FoxCutter/486Dev/README.md

# 486Dev
Repo for the 486 breadboard computer project
