FoxCutter/486Dev/Support Board/Support Board.kicad_pcb

## KiCad design Support Board/Support Board.kicad_pcb (2023-06-12)

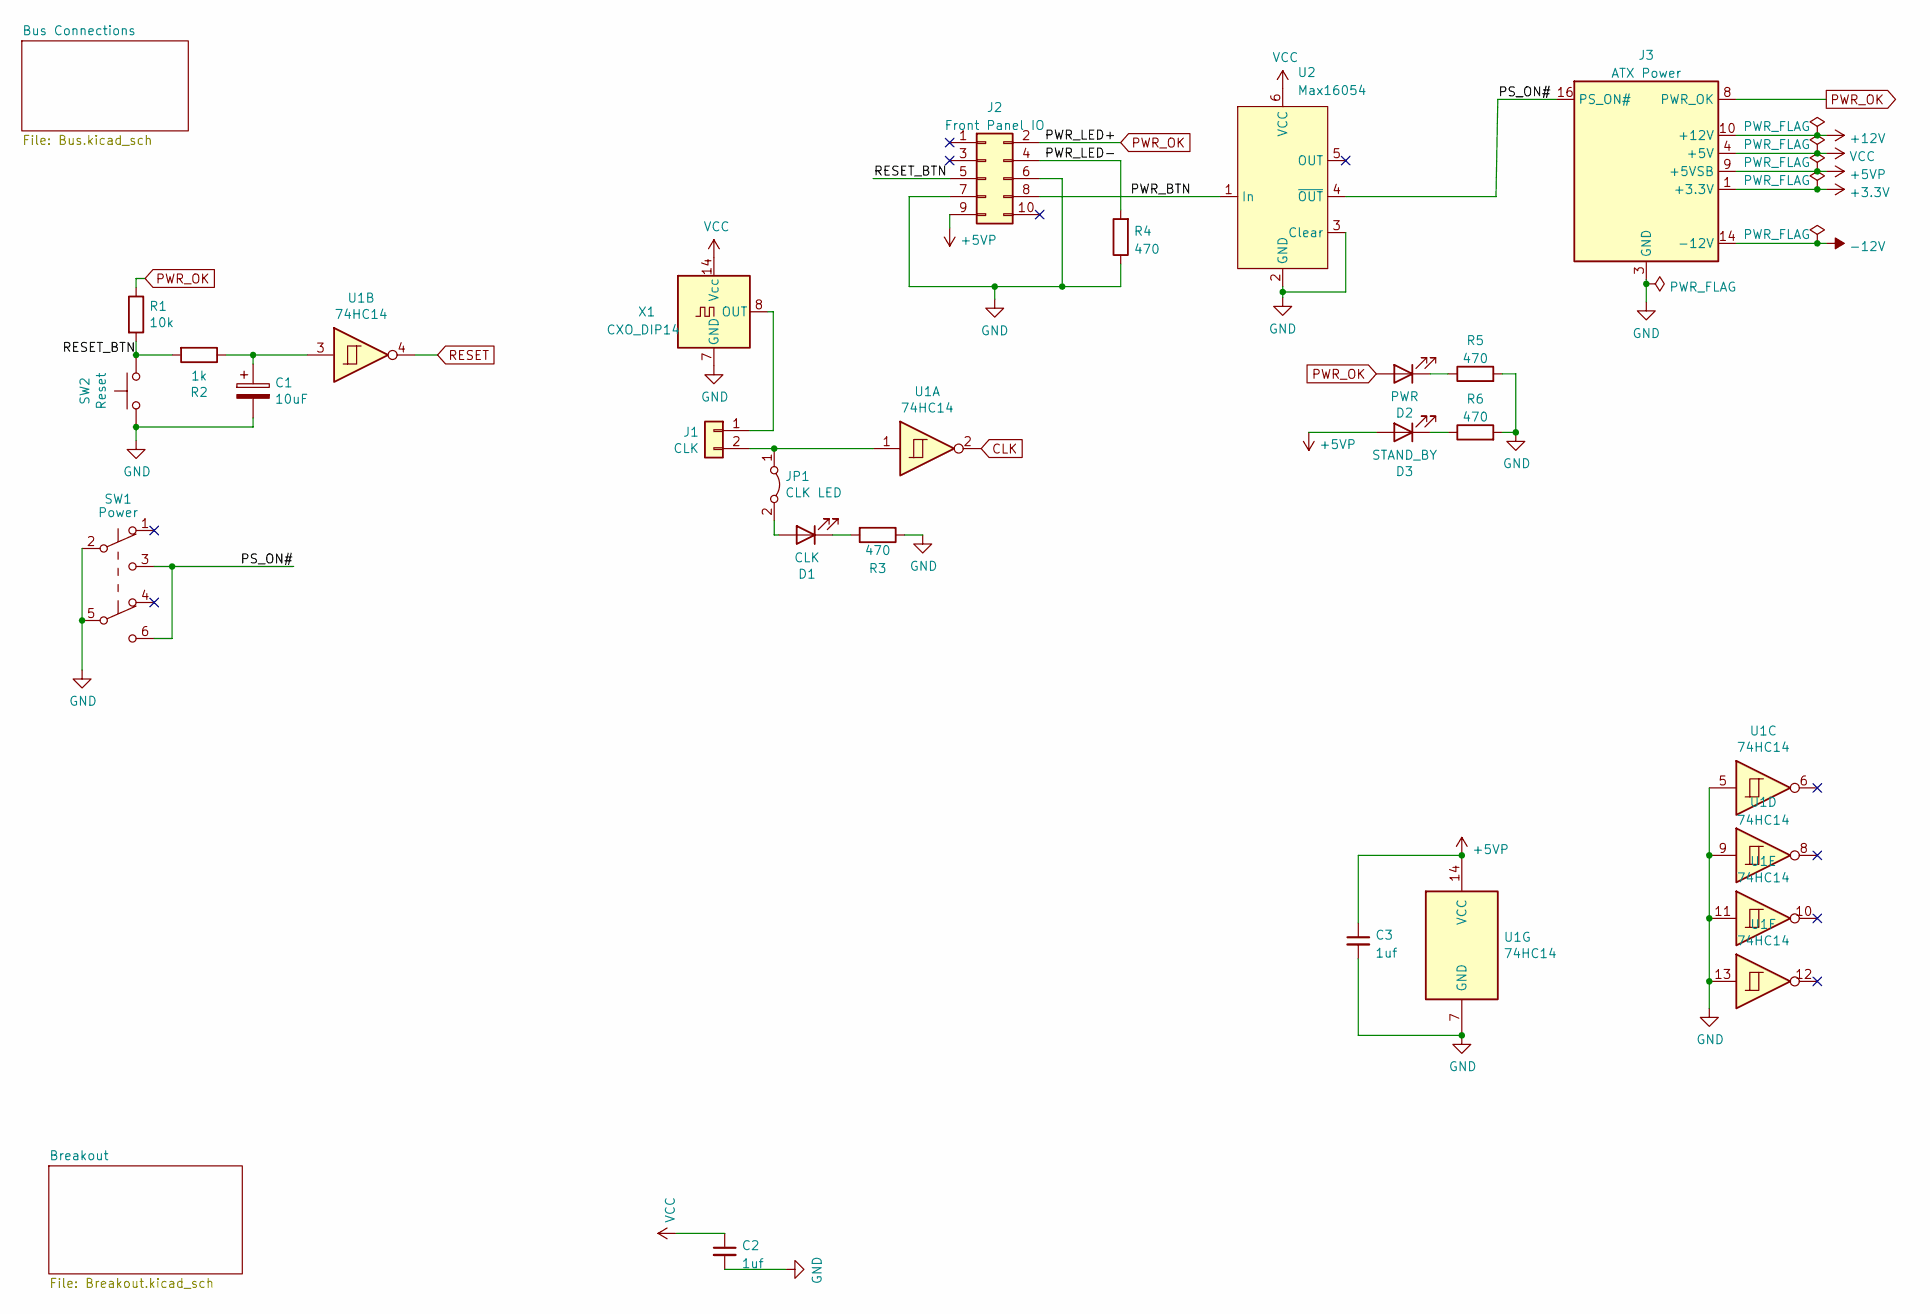
[picture p2: schematic Support Board.kicad_sch]

Parts:
C1: 10uF; CP_Radial_D5.0mm_P2.50mm
C2, C3: 1uf; C_0805_2012Metric_Pad1.18x1.45mm_HandSolder
D1: CLK; LED_0805_2012Metric_Pad1.15x1.40mm_HandSolder
D2: PWR; LED_0805_2012Metric_Pad1.15x1.40mm_HandSolder
D3: STAND_BY; LED_0805_2012Metric_Pad1.15x1.40mm_HandSolder
J1: CLK; PinHeader_1x02_P2.54mm_Vertical
J2: Front Panel IO; PinHeader_2x05_P2.54mm_Vertical
J3: ATX Power; Molex_Mini-Fit_Jr_5566-24A_2x12_P4.20mm_Vertical
JP1: CLK LED; PinHeader_1x02_P2.54mm_Vertical
R1: 10k; R_0805_2012Metric_Pad1.20x1.40mm_HandSolder
R2: 1k; R_0805_2012Metric_Pad1.20x1.40mm_HandSolder
R3, R4, R5, R6: 470; R_0805_2012Metric_Pad1.20x1.40mm_HandSolder
SW1: Power; 7mm x 7mm Tactile Switch
SW2: Reset; SW_PUSH_6mm
U1: 74HC14; SO-14_5.3x10.2mm_P1.27mm
U2: Max16054; TSOT-23-6
X1: CXO_DIP14; Oscillator_DIP-14

Connections:
+3.3V: J3.1 (+3.3V), J3.2 (+3.3V), J3.12 (+3.3V), J3.13 (+3.3V); also elsewhere on the board
+5VP: C3.1, D3.2 (A), J2.9, J3.9 (+5VSB), U1.14 (VCC); also elsewhere on the board
+12V: J3.10 (+12V), J3.11 (+12V); also elsewhere on the board
-12V: J3.14 (-12V); also elsewhere on the board
/PS_ON#: J3.16 (PS_ON#), SW1.3 (C), SW1.6 (C), U2.4 (~OUT)
/PWR_BTN: J2.8, U2.1 (In)
/PWR_LED-: J2.4, R4.2
/RESET_BTN: J2.5, R1.2, R2.2, SW2.2
CLK: U1.2; also elsewhere on the board
GND: C1.2, C2.2, C3.2, J2.6, J2.7, J3.3 (GND), J3.5 (GND), J3.7 (GND), J3.15 (GND), J3.17 (GND), J3.18 (GND), J3.19 (GND), J3.24 (GND), R3.1, R4.1, R5.2, R6.2, SW1.2 (B), SW1.5 (B), SW2.1, U1.5, U1.7 (GND), U1.9, U1.11, U1.13, U2.2 (GND), U2.3 (Clear), X1.7 (GND); also elsewhere on the board
unnamed: C1.1, R2.1, U1.3
unnamed: D1.1 (K), R3.2
unnamed: D1.2 (A), JP1.2 (B)
unnamed: D2.1 (K), R5.1
unnamed: D3.1 (K), R6.1
unnamed: J1.1, X1.8 (OUT)
unnamed: J1.2, JP1.1 (A), U1.1
PWR_OK: D2.2 (A), J2.2, J3.8 (PWR_OK), R1.1; also elsewhere on the board
RESET: U1.4; also elsewhere on the board
VCC: C2.1, J3.4 (+5V), J3.6 (+5V), J3.21 (+5V), J3.22 (+5V), J3.23 (+5V), U2.6 (VCC), X1.14 (Vcc); also elsewhere on the board

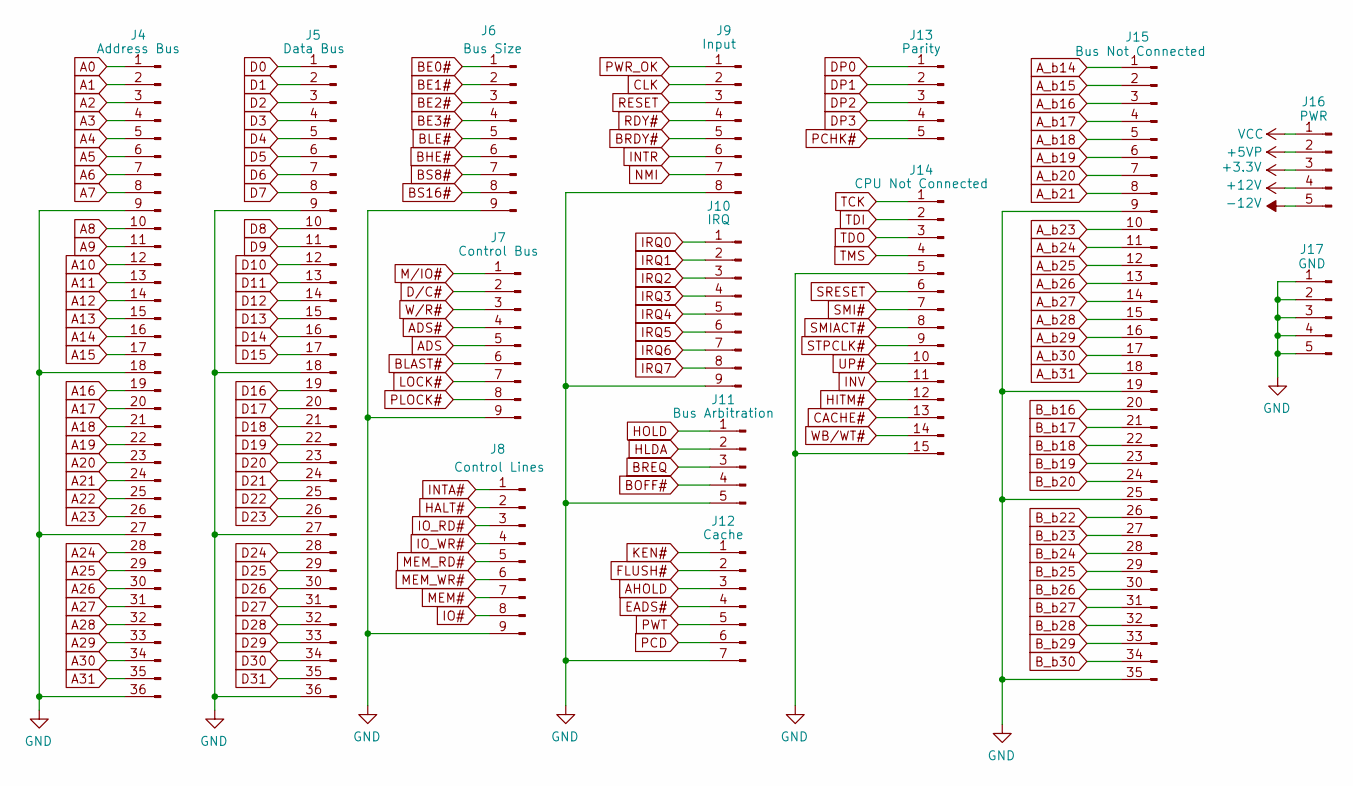
[picture p3: schematic Breakout.kicad_sch]

Parts:
J4: Address Bus; PinHeader_1x36_P2.54mm_Vertical
J5: Data Bus; PinHeader_1x36_P2.54mm_Vertical
J6: Bus Size; PinHeader_1x09_P2.54mm_Vertical
J7: Control Bus; PinHeader_1x09_P2.54mm_Vertical
J8: Control Lines; PinHeader_1x09_P2.54mm_Vertical
J9: Input; PinHeader_1x08_P2.54mm_Vertical
J10: IRQ; PinHeader_1x09_P2.54mm_Vertical
J11: Bus Arbitration; PinHeader_1x05_P2.54mm_Vertical
J12: Cache; PinHeader_1x07_P2.54mm_Vertical
J13: Parity; PinHeader_1x05_P2.54mm_Vertical
J14: CPU Not Connected; PinHeader_1x15_P2.54mm_Vertical
J15: Bus Not Connected; PinHeader_1x35_P2.54mm_Vertical
J16: PWR; PinHeader_1x05_P2.54mm_Vertical
J17: GND; PinHeader_1x05_P2.54mm_Vertical

Connections:
+3.3V: J16.3; also elsewhere on the board
+5VP: J16.2; also elsewhere on the board
+12V: J16.4; also elsewhere on the board
-12V: J16.5; also elsewhere on the board
A0: J4.1; also elsewhere on the board
A1: J4.2; also elsewhere on the board
A2: J4.3; also elsewhere on the board
A3: J4.4; also elsewhere on the board
A4: J4.5; also elsewhere on the board
A5: J4.6; also elsewhere on the board
A6: J4.7; also elsewhere on the board
A7: J4.8; also elsewhere on the board
A8: J4.10; also elsewhere on the board
A9: J4.11; also elsewhere on the board
A10: J4.12; also elsewhere on the board
A11: J4.13; also elsewhere on the board
A12: J4.14; also elsewhere on the board
A13: J4.15; also elsewhere on the board
A14: J4.16; also elsewhere on the board
A15: J4.17; also elsewhere on the board
A16: J4.19; also elsewhere on the board
A17: J4.20; also elsewhere on the board
A18: J4.21; also elsewhere on the board
A19: J4.22; also elsewhere on the board
A20: J4.23; also elsewhere on the board
A21: J4.24; also elsewhere on the board
A22: J4.25; also elsewhere on the board
A23: J4.26; also elsewhere on the board
A24: J4.28; also elsewhere on the board
A25: J4.29; also elsewhere on the board
A26: J4.30; also elsewhere on the board
A27: J4.31; also elsewhere on the board
A28: J4.32; also elsewhere on the board
A29: J4.33; also elsewhere on the board
A30: J4.34; also elsewhere on the board
A31: J4.35; also elsewhere on the board
ADS: J7.5; also elsewhere on the board
ADS#: J7.4; also elsewhere on the board
AHOLD: J12.3; also elsewhere on the board
A_b14: J15.1; also elsewhere on the board
A_b15: J15.2; also elsewhere on the board
A_b16: J15.3; also elsewhere on the board
A_b17: J15.4; also elsewhere on the board
A_b18: J15.5; also elsewhere on the board
A_b19: J15.6; also elsewhere on the board
A_b20: J15.7; also elsewhere on the board
A_b21: J15.8; also elsewhere on the board
A_b23: J15.10; also elsewhere on the board
A_b24: J15.11; also elsewhere on the board
A_b25: J15.12; also elsewhere on the board
A_b26: J15.13; also elsewhere on the board
A_b27: J15.14; also elsewhere on the board
A_b28: J15.15; also elsewhere on the board
A_b29: J15.16; also elsewhere on the board
A_b30: J15.17; also elsewhere on the board
A_b31: J15.18; also elsewhere on the board
BE0#: J6.1; also elsewhere on the board
BE1#: J6.2; also elsewhere on the board
BE2#: J6.3; also elsewhere on the board
BE3#: J6.4; also elsewhere on the board
BHE#: J6.6; also elsewhere on the board
BLAST#: J7.6; also elsewhere on the board
BLE#: J6.5; also elsewhere on the board
BOFF#: J11.4; also elsewhere on the board
BRDY#: J9.5; also elsewhere on the board
BREQ: J11.3; also elsewhere on the board
BS8#: J6.7; also elsewhere on the board
BS16#: J6.8; also elsewhere on the board
B_b16: J15.20; also elsewhere on the board
B_b17: J15.21; also elsewhere on the board
B_b18: J15.22; also elsewhere on the board
B_b19: J15.23; also elsewhere on the board
B_b20: J15.24; also elsewhere on the board
B_b22: J15.26; also elsewhere on the board
B_b23: J15.27; also elsewhere on the board
B_b24: J15.28; also elsewhere on the board
B_b25: J15.29; also elsewhere on the board
B_b26: J15.30; also elsewhere on the board
B_b27: J15.31; also elsewhere on the board
B_b28: J15.32; also elsewhere on the board
B_b29: J15.33; also elsewhere on the board
B_b30: J15.34; also elsewhere on the board
CACHE#: J14.13; also elsewhere on the board
CLK: J9.2; also elsewhere on the board
D0: J5.1; also elsewhere on the board
D1: J5.2; also elsewhere on the board
D2: J5.3; also elsewhere on the board
D3: J5.4; also elsewhere on the board
D4: J5.5; also elsewhere on the board
D5: J5.6; also elsewhere on the board
D6: J5.7; also elsewhere on the board
D7: J5.8; also elsewhere on the board
D8: J5.10; also elsewhere on the board
D9: J5.11; also elsewhere on the board
D10: J5.12; also elsewhere on the board
D11: J5.13; also elsewhere on the board
D12: J5.14; also elsewhere on the board
D13: J5.15; also elsewhere on the board
D14: J5.16; also elsewhere on the board
D15: J5.17; also elsewhere on the board
D16: J5.19; also elsewhere on the board
D17: J5.20; also elsewhere on the board
D18: J5.21; also elsewhere on the board
D19: J5.22; also elsewhere on the board
D20: J5.23; also elsewhere on the board
D21: J5.24; also elsewhere on the board
D22: J5.25; also elsewhere on the board
D23: J5.26; also elsewhere on the board
D24: J5.28; also elsewhere on the board
D25: J5.29; also elsewhere on the board
D26: J5.30; also elsewhere on the board
D27: J5.31; also elsewhere on the board
D28: J5.32; also elsewhere on the board
D29: J5.33; also elsewhere on the board
D30: J5.34; also elsewhere on the board
D31: J5.35; also elsewhere on the board
DP0: J13.1; also elsewhere on the board
DP1: J13.2; also elsewhere on the board
DP2: J13.3; also elsewhere on the board
DP3: J13.4; also elsewhere on the board
D/C#: J7.2; also elsewhere on the board
EADS#: J12.4; also elsewhere on the board
FLUSH#: J12.2; also elsewhere on the board
GND: J4.9, J4.18, J4.27, J4.36, J5.9, J5.18, J5.27, J5.36, J6.9, J7.9, J8.9, J9.8, J10.9, J11.5, J12.7, J14.5, J14.15, J15.9, J15.19, J15.25, J15.35, J17.1, J17.2, J17.3, J17.4, J17.5; also elsewhere on the board
HALT#: J8.2; also elsewhere on the board
HITM#: J14.12; also elsewhere on the board
HLDA: J11.2; also elsewhere on the board
HOLD: J11.1; also elsewhere on the board
INTA#: J8.1; also elsewhere on the board
INTR: J9.6; also elsewhere on the board
INV: J14.11; also elsewhere on the board
IO#: J8.8; also elsewhere on the board
IO_RD#: J8.3; also elsewhere on the board
IO_WR#: J8.4; also elsewhere on the board
IRQ0: J10.1; also elsewhere on the board
IRQ1: J10.2; also elsewhere on the board
IRQ2: J10.3; also elsewhere on the board
IRQ3: J10.4; also elsewhere on the board
IRQ4: J10.5; also elsewhere on the board
IRQ5: J10.6; also elsewhere on the board
IRQ6: J10.7; also elsewhere on the board
IRQ7: J10.8; also elsewhere on the board
KEN#: J12.1; also elsewhere on the board
LOCK#: J7.7; also elsewhere on the board
MEM#: J8.7; also elsewhere on the board
MEM_RD#: J8.5; also elsewhere on the board
MEM_WR#: J8.6; also elsewhere on the board
M/IO#: J7.1; also elsewhere on the board
NMI: J9.7; also elsewhere on the board
PCD: J12.6; also elsewhere on the board
PCHK#: J13.5; also elsewhere on the board
PLOCK#: J7.8; also elsewhere on the board
PWR_OK: J9.1; also elsewhere on the board
PWT: J12.5; also elsewhere on the board
RDY#: J9.4; also elsewhere on the board
RESET: J9.3; also elsewhere on the board
SMI#: J14.7; also elsewhere on the board
SMIACT#: J14.8; also elsewhere on the board
SRESET: J14.6; also elsewhere on the board
STPCLK#: J14.9; also elsewhere on the board
TCK: J14.1; also elsewhere on the board
TDI: J14.2; also elsewhere on the board
TDO: J14.3; also elsewhere on the board
TMS: J14.4; also elsewhere on the board
UP#: J14.10; also elsewhere on the board
VCC: J16.1; also elsewhere on the board
WB/WT#: J14.14; also elsewhere on the board
W/R#: J7.3; also elsewhere on the board

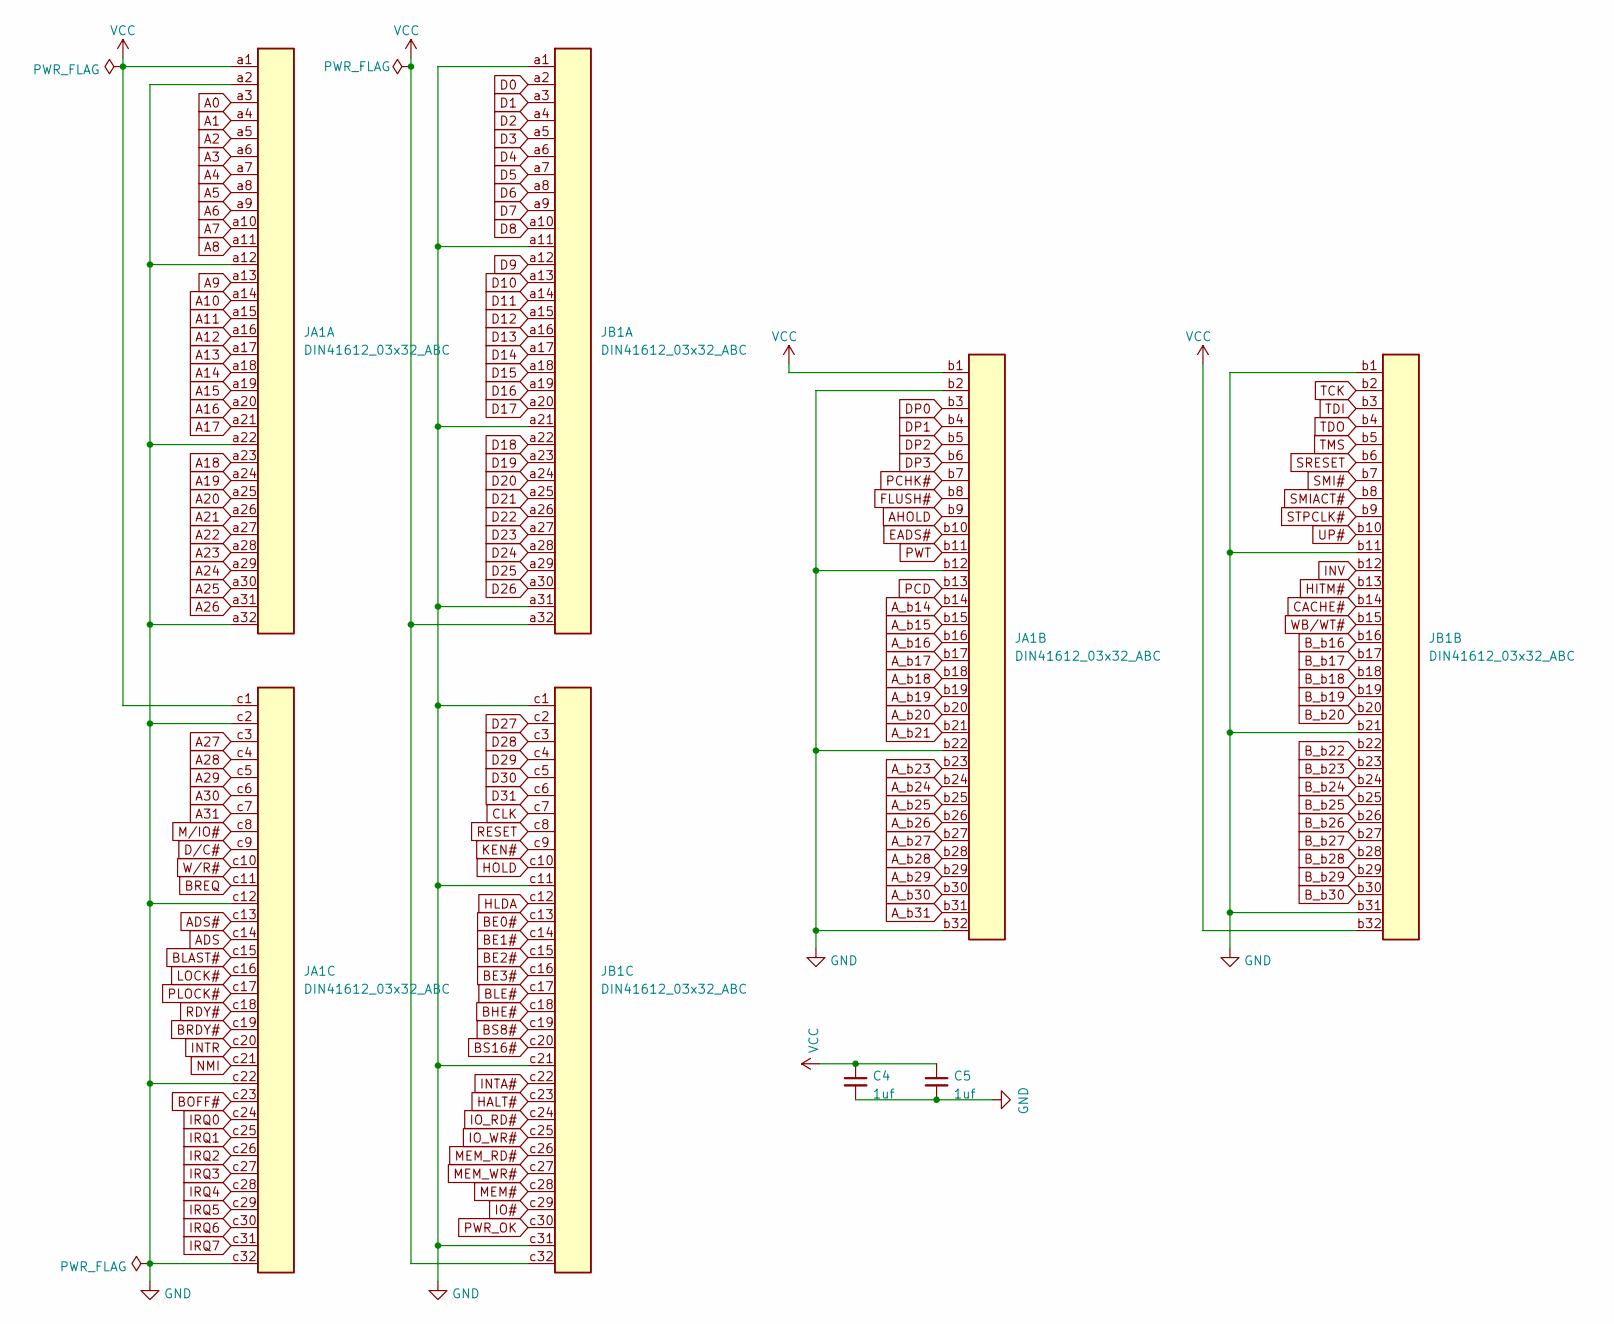
[picture p4: schematic Bus.kicad_sch]

Parts:
C4, C5: 1uf; C_0805_2012Metric_Pad1.18x1.45mm_HandSolder
JA1: DIN41612_03x32_ABC; DIN41612_R_3x32_Male_Horizontal_THT
JB1: DIN41612_03x32_ABC; DIN41612_R_3x32_Male_Horizontal_THT

Connections:
A0: JA1.a3; also elsewhere on the board
A1: JA1.a4; also elsewhere on the board
A2: JA1.a5; also elsewhere on the board
A3: JA1.a6; also elsewhere on the board
A4: JA1.a7; also elsewhere on the board
A5: JA1.a8; also elsewhere on the board
A6: JA1.a9; also elsewhere on the board
A7: JA1.a10; also elsewhere on the board
A8: JA1.a11; also elsewhere on the board
A9: JA1.a13; also elsewhere on the board
A10: JA1.a14; also elsewhere on the board
A11: JA1.a15; also elsewhere on the board
A12: JA1.a16; also elsewhere on the board
A13: JA1.a17; also elsewhere on the board
A14: JA1.a18; also elsewhere on the board
A15: JA1.a19; also elsewhere on the board
A16: JA1.a20; also elsewhere on the board
A17: JA1.a21; also elsewhere on the board
A18: JA1.a23; also elsewhere on the board
A19: JA1.a24; also elsewhere on the board
A20: JA1.a25; also elsewhere on the board
A21: JA1.a26; also elsewhere on the board
A22: JA1.a27; also elsewhere on the board
A23: JA1.a28; also elsewhere on the board
A24: JA1.a29; also elsewhere on the board
A25: JA1.a30; also elsewhere on the board
A26: JA1.a31; also elsewhere on the board
A27: JA1.c3; also elsewhere on the board
A28: JA1.c4; also elsewhere on the board
A29: JA1.c5; also elsewhere on the board
A30: JA1.c6; also elsewhere on the board
A31: JA1.c7; also elsewhere on the board
ADS: JA1.c14; also elsewhere on the board
ADS#: JA1.c13; also elsewhere on the board
AHOLD: JA1.b9; also elsewhere on the board
A_b14: JA1.b14; also elsewhere on the board
A_b15: JA1.b15; also elsewhere on the board
A_b16: JA1.b16; also elsewhere on the board
A_b17: JA1.b17; also elsewhere on the board
A_b18: JA1.b18; also elsewhere on the board
A_b19: JA1.b19; also elsewhere on the board
A_b20: JA1.b20; also elsewhere on the board
A_b21: JA1.b21; also elsewhere on the board
A_b23: JA1.b23; also elsewhere on the board
A_b24: JA1.b24; also elsewhere on the board
A_b25: JA1.b25; also elsewhere on the board
A_b26: JA1.b26; also elsewhere on the board
A_b27: JA1.b27; also elsewhere on the board
A_b28: JA1.b28; also elsewhere on the board
A_b29: JA1.b29; also elsewhere on the board
A_b30: JA1.b30; also elsewhere on the board
A_b31: JA1.b31; also elsewhere on the board
BE0#: JB1.c13; also elsewhere on the board
BE1#: JB1.c14; also elsewhere on the board
BE2#: JB1.c15; also elsewhere on the board
BE3#: JB1.c16; also elsewhere on the board
BHE#: JB1.c18; also elsewhere on the board
BLAST#: JA1.c15; also elsewhere on the board
BLE#: JB1.c17; also elsewhere on the board
BOFF#: JA1.c23; also elsewhere on the board
BRDY#: JA1.c19; also elsewhere on the board
BREQ: JA1.c11; also elsewhere on the board
BS8#: JB1.c19; also elsewhere on the board
BS16#: JB1.c20; also elsewhere on the board
B_b16: JB1.b16; also elsewhere on the board
B_b17: JB1.b17; also elsewhere on the board
B_b18: JB1.b18; also elsewhere on the board
B_b19: JB1.b19; also elsewhere on the board
B_b20: JB1.b20; also elsewhere on the board
B_b22: JB1.b22; also elsewhere on the board
B_b23: JB1.b23; also elsewhere on the board
B_b24: JB1.b24; also elsewhere on the board
B_b25: JB1.b25; also elsewhere on the board
B_b26: JB1.b26; also elsewhere on the board
B_b27: JB1.b27; also elsewhere on the board
B_b28: JB1.b28; also elsewhere on the board
B_b29: JB1.b29; also elsewhere on the board
B_b30: JB1.b30; also elsewhere on the board
CACHE#: JB1.b14; also elsewhere on the board
CLK: JB1.c7; also elsewhere on the board
D0: JB1.a2; also elsewhere on the board
D1: JB1.a3; also elsewhere on the board
D2: JB1.a4; also elsewhere on the board
D3: JB1.a5; also elsewhere on the board
D4: JB1.a6; also elsewhere on the board
D5: JB1.a7; also elsewhere on the board
D6: JB1.a8; also elsewhere on the board
D7: JB1.a9; also elsewhere on the board
D8: JB1.a10; also elsewhere on the board
D9: JB1.a12; also elsewhere on the board
D10: JB1.a13; also elsewhere on the board
D11: JB1.a14; also elsewhere on the board
D12: JB1.a15; also elsewhere on the board
D13: JB1.a16; also elsewhere on the board
D14: JB1.a17; also elsewhere on the board
D15: JB1.a18; also elsewhere on the board
D16: JB1.a19; also elsewhere on the board
D17: JB1.a20; also elsewhere on the board
D18: JB1.a22; also elsewhere on the board
D19: JB1.a23; also elsewhere on the board
D20: JB1.a24; also elsewhere on the board
D21: JB1.a25; also elsewhere on the board
D22: JB1.a26; also elsewhere on the board
D23: JB1.a27; also elsewhere on the board
D24: JB1.a28; also elsewhere on the board
D25: JB1.a29; also elsewhere on the board
D26: JB1.a30; also elsewhere on the board
D27: JB1.c2; also elsewhere on the board
D28: JB1.c3; also elsewhere on the board
D29: JB1.c4; also elsewhere on the board
D30: JB1.c5; also elsewhere on the board
D31: JB1.c6; also elsewhere on the board
DP0: JA1.b3; also elsewhere on the board
DP1: JA1.b4; also elsewhere on the board
DP2: JA1.b5; also elsewhere on the board
DP3: JA1.b6; also elsewhere on the board
D/C#: JA1.c9; also elsewhere on the board
EADS#: JA1.b10; also elsewhere on the board
FLUSH#: JA1.b8; also elsewhere on the board
GND: C4.2, C5.2, JA1.a2, JA1.a12, JA1.a22, JA1.a32, JA1.b2, JA1.b12, JA1.b22, JA1.b32, JA1.c2, JA1.c12, JA1.c22, JA1.c32, JB1.a1, JB1.a11, JB1.a21, JB1.a31, JB1.b1, JB1.b11, JB1.b21, JB1.b31, JB1.c1, JB1.c11, JB1.c21, JB1.c31; also elsewhere on the board
HALT#: JB1.c23; also elsewhere on the board
HITM#: JB1.b13; also elsewhere on the board
HLDA: JB1.c12; also elsewhere on the board
HOLD: JB1.c10; also elsewhere on the board
INTA#: JB1.c22; also elsewhere on the board
INTR: JA1.c20; also elsewhere on the board
INV: JB1.b12; also elsewhere on the board
IO#: JB1.c29; also elsewhere on the board
IO_RD#: JB1.c24; also elsewhere on the board
IO_WR#: JB1.c25; also elsewhere on the board
IRQ0: JA1.c24; also elsewhere on the board
IRQ1: JA1.c25; also elsewhere on the board
IRQ2: JA1.c26; also elsewhere on the board
IRQ3: JA1.c27; also elsewhere on the board
IRQ4: JA1.c28; also elsewhere on the board
IRQ5: JA1.c29; also elsewhere on the board
IRQ6: JA1.c30; also elsewhere on the board
IRQ7: JA1.c31; also elsewhere on the board
KEN#: JB1.c9; also elsewhere on the board
LOCK#: JA1.c16; also elsewhere on the board
MEM#: JB1.c28; also elsewhere on the board
MEM_RD#: JB1.c26; also elsewhere on the board
MEM_WR#: JB1.c27; also elsewhere on the board
M/IO#: JA1.c8; also elsewhere on the board
NMI: JA1.c21; also elsewhere on the board
PCD: JA1.b13; also elsewhere on the board
PCHK#: JA1.b7; also elsewhere on the board
PLOCK#: JA1.c17; also elsewhere on the board
PWR_OK: JB1.c30; also elsewhere on the board
PWT: JA1.b11; also elsewhere on the board
RDY#: JA1.c18; also elsewhere on the board
RESET: JB1.c8; also elsewhere on the board
SMI#: JB1.b7; also elsewhere on the board
SMIACT#: JB1.b8; also elsewhere on the board
SRESET: JB1.b6; also elsewhere on the board
STPCLK#: JB1.b9; also elsewhere on the board
TCK: JB1.b2; also elsewhere on the board
TDI: JB1.b3; also elsewhere on the board
TDO: JB1.b4; also elsewhere on the board
TMS: JB1.b5; also elsewhere on the board
UP#: JB1.b10; also elsewhere on the board
VCC: C4.1, C5.1, JA1.a1, JA1.b1, JA1.c1, JB1.a32, JB1.b32, JB1.c32; also elsewhere on the board
WB/WT#: JB1.b15; also elsewhere on the board
W/R#: JA1.c10; also elsewhere on the board

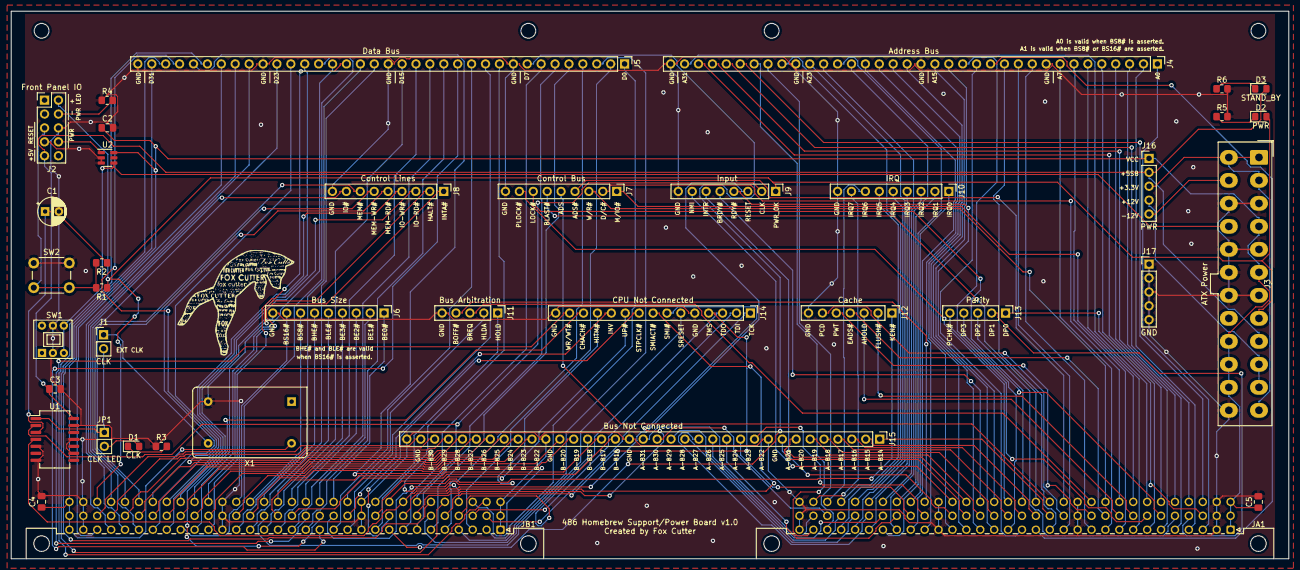
[picture p5: board Support Board.kicad_pcb from above]

Board: 2 copper layers, 233.3 x 100.0 mm, 43 parts (0 on the bottom side), 179 nets.

Other parts of the board:
REF1, REF2, REF3, REF4: MountingHole_2.7mm_M2.5_ISO7380
