FoxCutter/486Dev/Layout Template/Layout Template.kicad_pcb

## KiCad design Layout Template/Layout Template.kicad_pcb (2023-06-12)

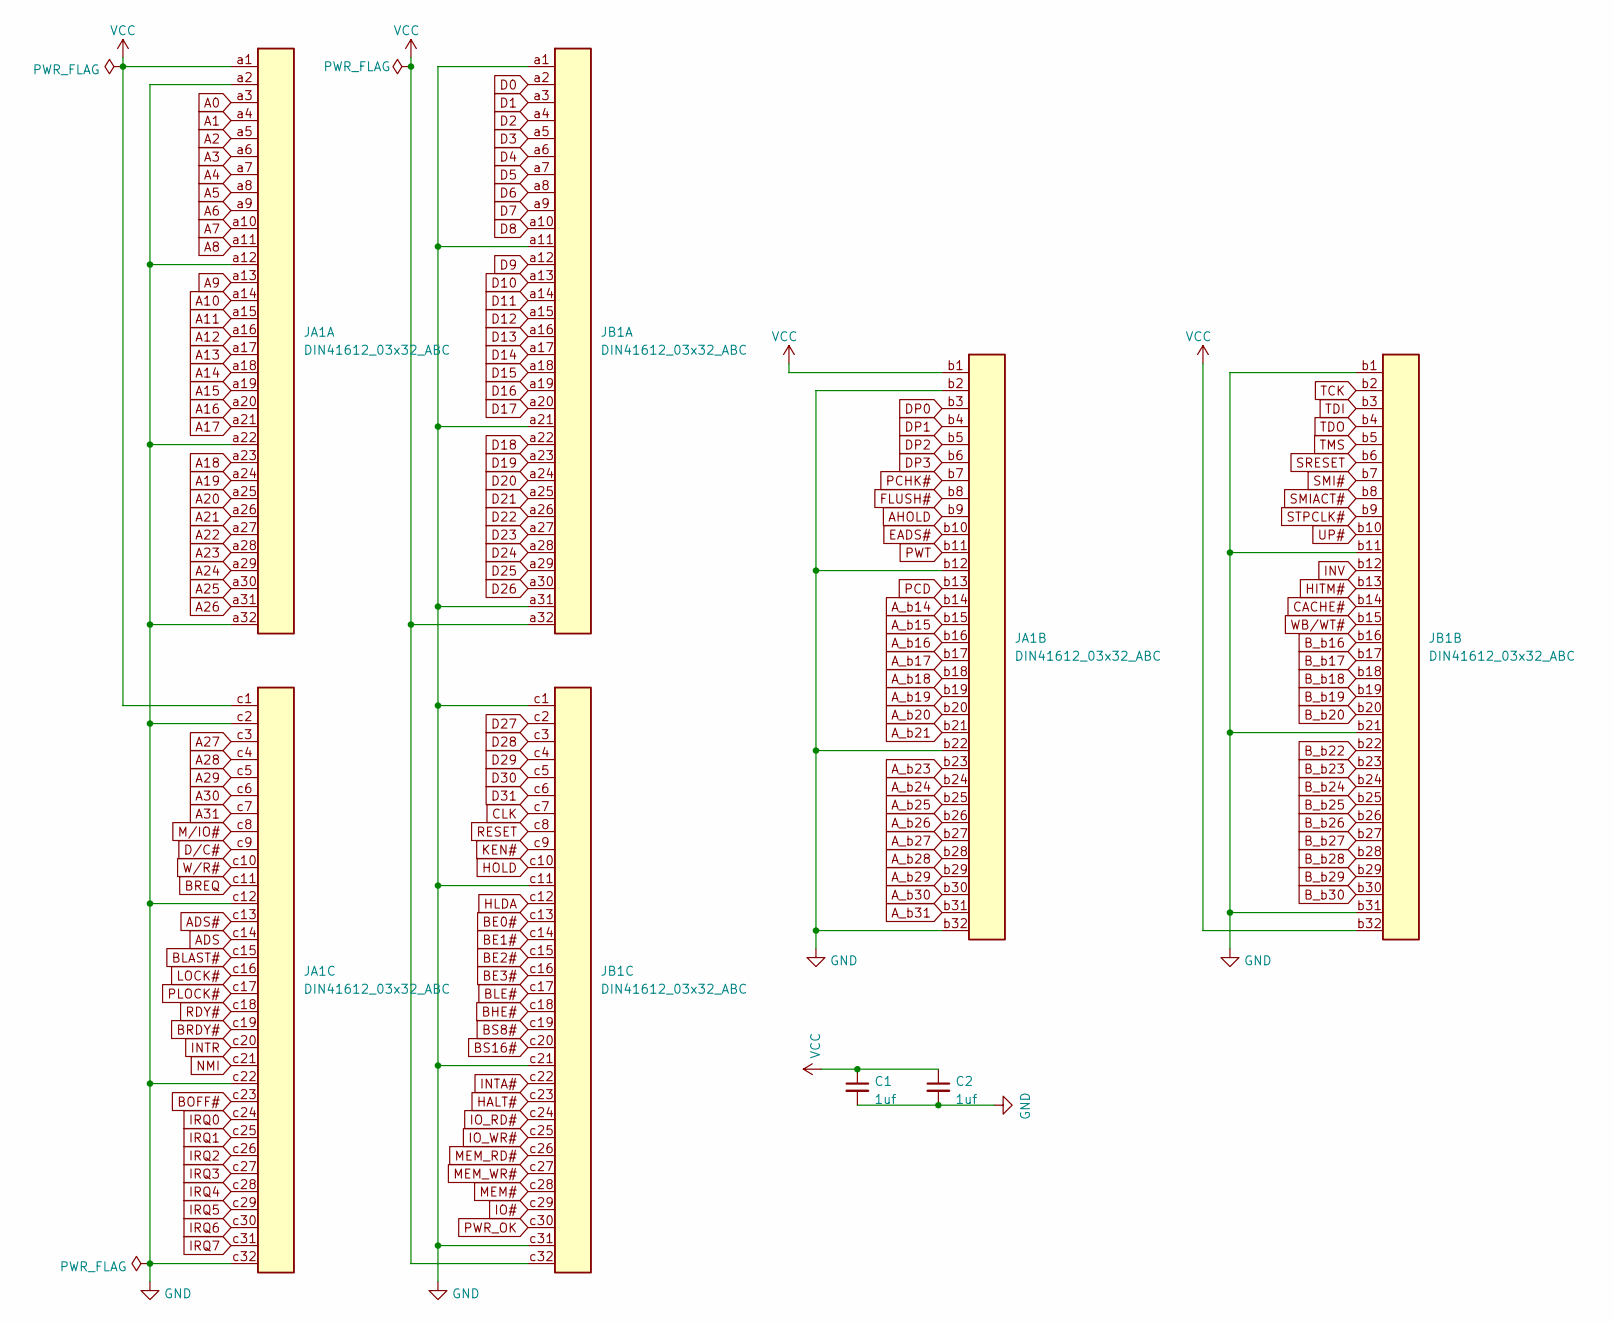
[picture p6: schematic Layout Template.kicad_sch]

Parts:
C1, C2: 1uf; C_Disc_D4.7mm_W2.5mm_P5.00mm
JA1: DIN41612_03x32_ABC; DIN41612_R_3x32_Male_Horizontal_THT
JB1: DIN41612_03x32_ABC; DIN41612_R_3x32_Male_Horizontal_THT

Connections:
A0: JA1.a3
A1: JA1.a4
A2: JA1.a5
A3: JA1.a6
A4: JA1.a7
A5: JA1.a8
A6: JA1.a9
A7: JA1.a10
A8: JA1.a11
A9: JA1.a13
A10: JA1.a14
A11: JA1.a15
A12: JA1.a16
A13: JA1.a17
A14: JA1.a18
A15: JA1.a19
A16: JA1.a20
A17: JA1.a21
A18: JA1.a23
A19: JA1.a24
A20: JA1.a25
A21: JA1.a26
A22: JA1.a27
A23: JA1.a28
A24: JA1.a29
A25: JA1.a30
A26: JA1.a31
A27: JA1.c3
A28: JA1.c4
A29: JA1.c5
A30: JA1.c6
A31: JA1.c7
ADS: JA1.c14
ADS#: JA1.c13
AHOLD: JA1.b9
A_b14: JA1.b14
A_b15: JA1.b15
A_b16: JA1.b16
A_b17: JA1.b17
A_b18: JA1.b18
A_b19: JA1.b19
A_b20: JA1.b20
A_b21: JA1.b21
A_b23: JA1.b23
A_b24: JA1.b24
A_b25: JA1.b25
A_b26: JA1.b26
A_b27: JA1.b27
A_b28: JA1.b28
A_b29: JA1.b29
A_b30: JA1.b30
A_b31: JA1.b31
BE0#: JB1.c13
BE1#: JB1.c14
BE2#: JB1.c15
BE3#: JB1.c16
BHE#: JB1.c18
BLAST#: JA1.c15
BLE#: JB1.c17
BOFF#: JA1.c23
BRDY#: JA1.c19
BREQ: JA1.c11
BS8#: JB1.c19
BS16#: JB1.c20
B_b16: JB1.b16
B_b17: JB1.b17
B_b18: JB1.b18
B_b19: JB1.b19
B_b20: JB1.b20
B_b22: JB1.b22
B_b23: JB1.b23
B_b24: JB1.b24
B_b25: JB1.b25
B_b26: JB1.b26
B_b27: JB1.b27
B_b28: JB1.b28
B_b29: JB1.b29
B_b30: JB1.b30
CACHE#: JB1.b14
CLK: JB1.c7
D0: JB1.a2
D1: JB1.a3
D2: JB1.a4
D3: JB1.a5
D4: JB1.a6
D5: JB1.a7
D6: JB1.a8
D7: JB1.a9
D8: JB1.a10
D9: JB1.a12
D10: JB1.a13
D11: JB1.a14
D12: JB1.a15
D13: JB1.a16
D14: JB1.a17
D15: JB1.a18
D16: JB1.a19
D17: JB1.a20
D18: JB1.a22
D19: JB1.a23
D20: JB1.a24
D21: JB1.a25
D22: JB1.a26
D23: JB1.a27
D24: JB1.a28
D25: JB1.a29
D26: JB1.a30
D27: JB1.c2
D28: JB1.c3
D29: JB1.c4
D30: JB1.c5
D31: JB1.c6
DP0: JA1.b3
DP1: JA1.b4
DP2: JA1.b5
DP3: JA1.b6
D/C#: JA1.c9
EADS#: JA1.b10
FLUSH#: JA1.b8
GND: C1.2, C2.2, JA1.a2, JA1.a12, JA1.a22, JA1.a32, JA1.b2, JA1.b12, JA1.b22, JA1.b32, JA1.c2, JA1.c12, JA1.c22, JA1.c32, JB1.a1, JB1.a11, JB1.a21, JB1.a31, JB1.b1, JB1.b11, JB1.b21, JB1.b31, JB1.c1, JB1.c11, JB1.c21, JB1.c31
HALT#: JB1.c23
HITM#: JB1.b13
HLDA: JB1.c12
HOLD: JB1.c10
INTA#: JB1.c22
INTR: JA1.c20
INV: JB1.b12
IO#: JB1.c29
IO_RD#: JB1.c24
IO_WR#: JB1.c25
IRQ0: JA1.c24
IRQ1: JA1.c25
IRQ2: JA1.c26
IRQ3: JA1.c27
IRQ4: JA1.c28
IRQ5: JA1.c29
IRQ6: JA1.c30
IRQ7: JA1.c31
KEN#: JB1.c9
LOCK#: JA1.c16
MEM#: JB1.c28
MEM_RD#: JB1.c26
MEM_WR#: JB1.c27
M/IO#: JA1.c8
NMI: JA1.c21
PCD: JA1.b13
PCHK#: JA1.b7
PLOCK#: JA1.c17
PWR_OK: JB1.c30
PWT: JA1.b11
RDY#: JA1.c18
RESET: JB1.c8
SMI#: JB1.b7
SMIACT#: JB1.b8
SRESET: JB1.b6
STPCLK#: JB1.b9
TCK: JB1.b2
TDI: JB1.b3
TDO: JB1.b4
TMS: JB1.b5
UP#: JB1.b10
VCC: C1.1, C2.1, JA1.a1, JA1.b1, JA1.c1, JB1.a32, JB1.b32, JB1.c32
WB/WT#: JB1.b15
W/R#: JA1.c10

Board: 2 copper layers, 8 parts (0 on the bottom side), 2 nets, no tracks yet.

Other parts of the board:
REF1, REF2, REF3, REF4: MountingHole_2.7mm_M2.5_ISO7380
