FoxCutter/486Dev/486 Breakout/486 Breakout.kicad_pcb

## KiCad design 486 Breakout/486 Breakout.kicad_pcb (2023-05-29)

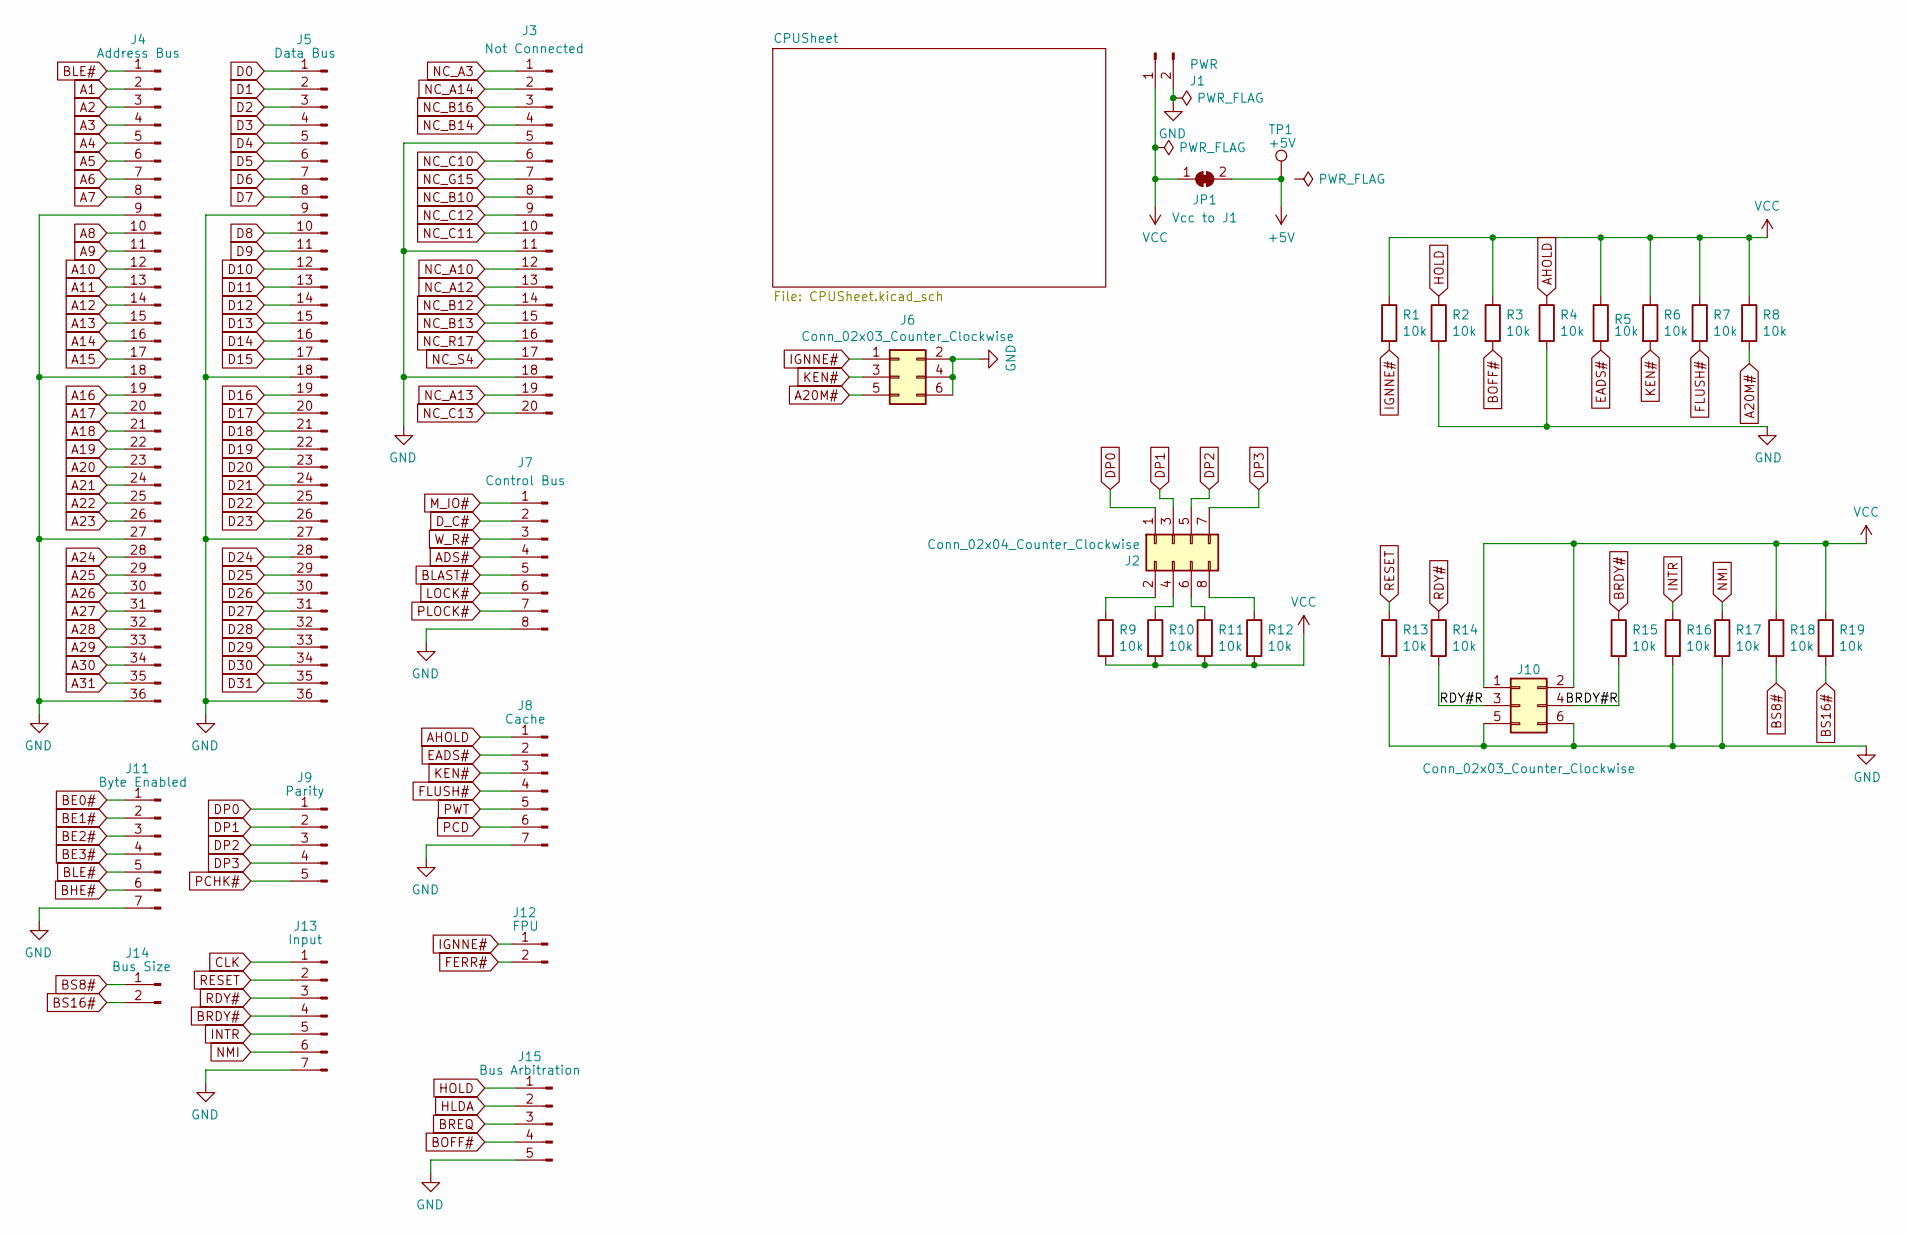
[picture p7: schematic 486 Breakout.kicad_sch]

Parts:
J1: PWR; PinHeader_1x02_P2.54mm_Vertical
J2: Conn_02x04_Counter_Clockwise; PinHeader_2x04_P2.54mm_Vertical
J3: Not Connected; PinHeader_1x20_P2.54mm_Vertical
J4: Address Bus; PinHeader_1x36_P2.54mm_Vertical
J5: Data Bus; PinHeader_1x36_P2.54mm_Vertical
J6, J10: Conn_02x03_Counter_Clockwise; PinHeader_2x03_P2.54mm_Vertical
J7: Control Bus; PinHeader_1x08_P2.54mm_Vertical
J8: Cache; PinHeader_1x07_P2.54mm_Vertical
J9: Parity; PinHeader_1x05_P2.54mm_Vertical
J11: Byte Enabled; PinHeader_1x07_P2.54mm_Vertical
J12: FPU; PinHeader_1x02_P2.54mm_Vertical
J13: Input; PinHeader_1x07_P2.54mm_Vertical
J14: Bus Size; PinHeader_1x02_P2.54mm_Vertical
J15: Bus Arbitration; PinHeader_1x05_P2.54mm_Vertical
JP1: Vcc to J1; SolderJumper-2_P1.3mm_Bridged_Pad1.0x1.5mm
R1, R2, R3, R4, R5, R6, R7, R8, R9, R10, R11, R12, R13, R14, R15, R16, R17, R18, R19: 10k; R_Axial_DIN0204_L3.6mm_D1.6mm_P7.62mm_Horizontal
TP1: +5V; TestPoint_Pad_2.0x2.0mm

Connections:
+5V: JP1.2 (B), TP1.1; also elsewhere on the board
/BRDY#R: J10.4, R15.2
/RDY#R: J10.3, R14.2
A1: J4.2; also elsewhere on the board
A2: J4.3; also elsewhere on the board
A3: J4.4; also elsewhere on the board
A4: J4.5; also elsewhere on the board
A5: J4.6; also elsewhere on the board
A6: J4.7; also elsewhere on the board
A7: J4.8; also elsewhere on the board
A8: J4.10; also elsewhere on the board
A9: J4.11; also elsewhere on the board
A10: J4.12; also elsewhere on the board
A11: J4.13; also elsewhere on the board
A12: J4.14; also elsewhere on the board
A13: J4.15; also elsewhere on the board
A14: J4.16; also elsewhere on the board
A15: J4.17; also elsewhere on the board
A16: J4.19; also elsewhere on the board
A17: J4.20; also elsewhere on the board
A18: J4.21; also elsewhere on the board
A19: J4.22; also elsewhere on the board
A20: J4.23; also elsewhere on the board
A20M#: J6.5, R8.2; also elsewhere on the board
A21: J4.24; also elsewhere on the board
A22: J4.25; also elsewhere on the board
A23: J4.26; also elsewhere on the board
A24: J4.28; also elsewhere on the board
A25: J4.29; also elsewhere on the board
A26: J4.30; also elsewhere on the board
A27: J4.31; also elsewhere on the board
A28: J4.32; also elsewhere on the board
A29: J4.33; also elsewhere on the board
A30: J4.34; also elsewhere on the board
A31: J4.35; also elsewhere on the board
ADS#: J7.4; also elsewhere on the board
AHOLD: J8.1, R4.1; also elsewhere on the board
BE0#: J11.1; also elsewhere on the board
BE1#: J11.2; also elsewhere on the board
BE2#: J11.3; also elsewhere on the board
BE3#: J11.4; also elsewhere on the board
BHE#: J11.6; also elsewhere on the board
BLAST#: J7.5; also elsewhere on the board
BLE#: J4.1, J11.5; also elsewhere on the board
BOFF#: J15.4, R3.2; also elsewhere on the board
BRDY#: J13.4, R15.1; also elsewhere on the board
BREQ: J15.3; also elsewhere on the board
BS8#: J14.1, R18.2; also elsewhere on the board
BS16#: J14.2, R19.2; also elsewhere on the board
CLK: J13.1; also elsewhere on the board
D0: J5.1; also elsewhere on the board
D1: J5.2; also elsewhere on the board
D2: J5.3; also elsewhere on the board
D3: J5.4; also elsewhere on the board
D4: J5.5; also elsewhere on the board
D5: J5.6; also elsewhere on the board
D6: J5.7; also elsewhere on the board
D7: J5.8; also elsewhere on the board
D8: J5.10; also elsewhere on the board
D9: J5.11; also elsewhere on the board
D10: J5.12; also elsewhere on the board
D11: J5.13; also elsewhere on the board
D12: J5.14; also elsewhere on the board
D13: J5.15; also elsewhere on the board
D14: J5.16; also elsewhere on the board
D15: J5.17; also elsewhere on the board
D16: J5.19; also elsewhere on the board
D17: J5.20; also elsewhere on the board
D18: J5.21; also elsewhere on the board
D19: J5.22; also elsewhere on the board
D20: J5.23; also elsewhere on the board
D21: J5.24; also elsewhere on the board
D22: J5.25; also elsewhere on the board
D23: J5.26; also elsewhere on the board
D24: J5.28; also elsewhere on the board
D25: J5.29; also elsewhere on the board
D26: J5.30; also elsewhere on the board
D27: J5.31; also elsewhere on the board
D28: J5.32; also elsewhere on the board
D29: J5.33; also elsewhere on the board
D30: J5.34; also elsewhere on the board
D31: J5.35; also elsewhere on the board
DP0: J2.1, J9.1; also elsewhere on the board
DP1: J2.3, J9.2; also elsewhere on the board
DP2: J2.5, J9.3; also elsewhere on the board
DP3: J2.7, J9.4; also elsewhere on the board
D_C#: J7.2; also elsewhere on the board
EADS#: J8.2, R5.2; also elsewhere on the board
FERR#: J12.2; also elsewhere on the board
FLUSH#: J8.4, R7.2; also elsewhere on the board
GND: J1.2, J3.5, J3.11, J3.18, J4.9, J4.18, J4.27, J4.36, J5.9, J5.18, J5.27, J5.36, J6.2, J6.4, J6.6, J7.8, J8.7, J10.5, J10.6, J11.7, J13.7, J15.5, R2.2, R4.2, R13.2, R16.2, R17.2; also elsewhere on the board
HLDA: J15.2; also elsewhere on the board
HOLD: J15.1, R2.1; also elsewhere on the board
IGNNE#: J6.1, J12.1, R1.2; also elsewhere on the board
INTR: J13.5, R16.1; also elsewhere on the board
KEN#: J6.3, J8.3, R6.2; also elsewhere on the board
LOCK#: J7.6; also elsewhere on the board
M_IO#: J7.1; also elsewhere on the board
NC_A3: J3.1; also elsewhere on the board
NC_A10: J3.12; also elsewhere on the board
NC_A12: J3.13; also elsewhere on the board
NC_A13: J3.19; also elsewhere on the board
NC_A14: J3.2; also elsewhere on the board
NC_B10: J3.8; also elsewhere on the board
NC_B12: J3.14; also elsewhere on the board
NC_B13: J3.15; also elsewhere on the board
NC_B14: J3.4; also elsewhere on the board
NC_B16: J3.3; also elsewhere on the board
NC_C10: J3.6; also elsewhere on the board
NC_C11: J3.10; also elsewhere on the board
NC_C12: J3.9; also elsewhere on the board
NC_C13: J3.20; also elsewhere on the board
NC_G15: J3.7; also elsewhere on the board
NC_R17: J3.16; also elsewhere on the board
NC_S4: J3.17; also elsewhere on the board
NMI: J13.6, R17.1; also elsewhere on the board
unnamed: J2.2, R9.1
unnamed: J2.4, R10.1
unnamed: J2.6, R11.1
unnamed: J2.8, R12.1
PCD: J8.6; also elsewhere on the board
PCHK#: J9.5; also elsewhere on the board
PLOCK#: J7.7; also elsewhere on the board
PWT: J8.5; also elsewhere on the board
RDY#: J13.3, R14.1; also elsewhere on the board
RESET: J13.2, R13.1; also elsewhere on the board
VCC: J1.1, J10.1, J10.2, JP1.1 (A), R1.1, R3.1, R5.1, R6.1, R7.1, R8.1, R9.2, R10.2, R11.2, R12.2, R18.1, R19.1; also elsewhere on the board
W_R#: J7.3; also elsewhere on the board

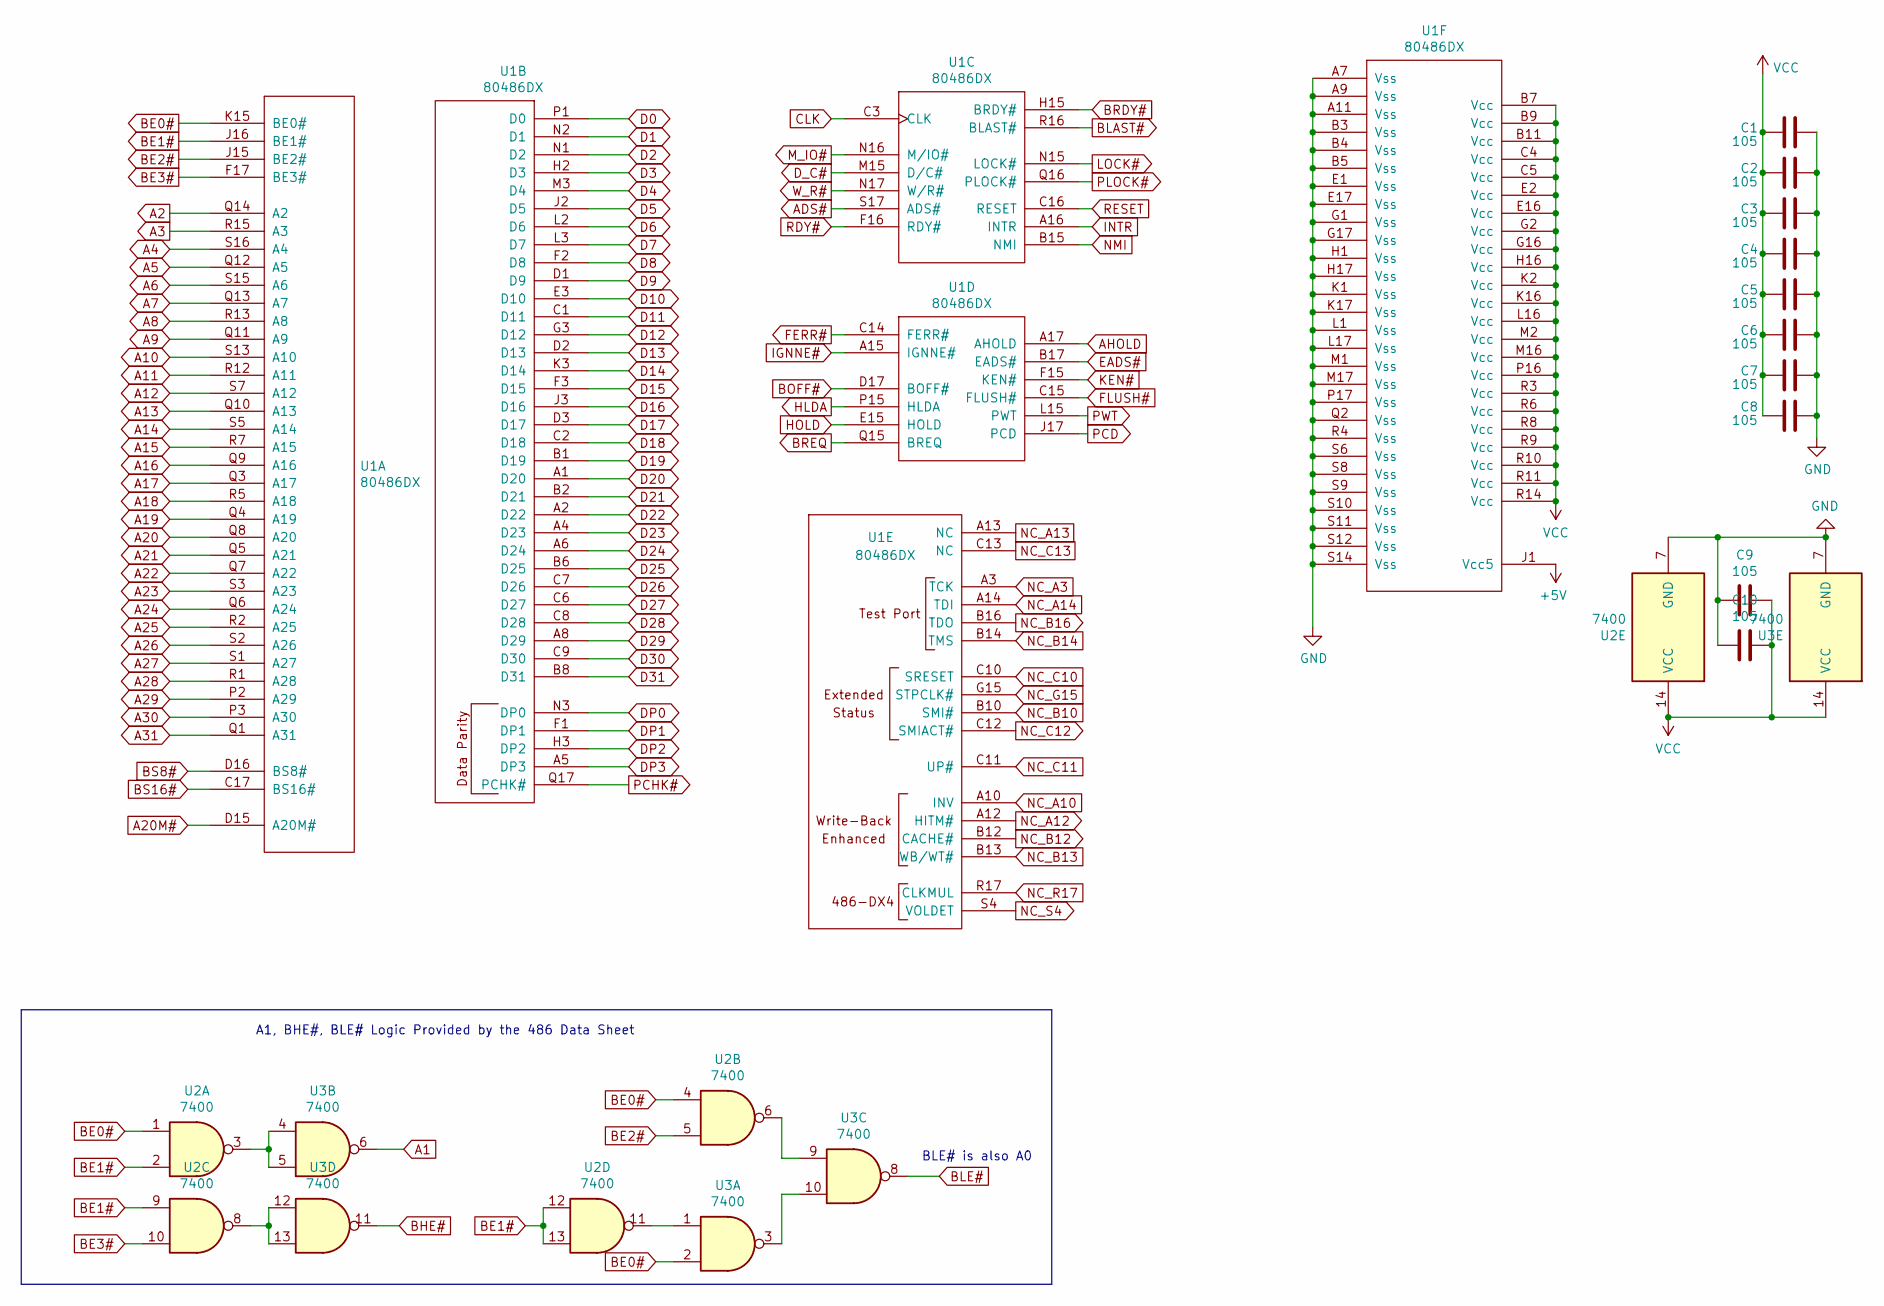
[picture p8: schematic CPUSheet.kicad_sch]

Parts:
C1, C2, C3, C4, C5, C6, C7, C8: 105; C_0805_2012Metric_Pad1.18x1.45mm_HandSolder
C9, C10: 105; C_Disc_D3.4mm_W2.1mm_P2.50mm
U1: 80486DX; PGA169
U2, U3: 7400; DIP-14_W7.62mm

Connections:
+5V: U1.J1 (Vcc5); also elsewhere on the board
A1: U3.6; also elsewhere on the board
A2: U1.Q14 (A2); also elsewhere on the board
A3: U1.R15 (A3); also elsewhere on the board
A4: U1.S16 (A4); also elsewhere on the board
A5: U1.Q12 (A5); also elsewhere on the board
A6: U1.S15 (A6); also elsewhere on the board
A7: U1.Q13 (A7); also elsewhere on the board
A8: U1.R13 (A8); also elsewhere on the board
A9: U1.Q11 (A9); also elsewhere on the board
A10: U1.S13 (A10); also elsewhere on the board
A11: U1.R12 (A11); also elsewhere on the board
A12: U1.S7 (A12); also elsewhere on the board
A13: U1.Q10 (A13); also elsewhere on the board
A14: U1.S5 (A14); also elsewhere on the board
A15: U1.R7 (A15); also elsewhere on the board
A16: U1.Q9 (A16); also elsewhere on the board
A17: U1.Q3 (A17); also elsewhere on the board
A18: U1.R5 (A18); also elsewhere on the board
A19: U1.Q4 (A19); also elsewhere on the board
A20: U1.Q8 (A20); also elsewhere on the board
A20M#: U1.D15 (A20M#); also elsewhere on the board
A21: U1.Q5 (A21); also elsewhere on the board
A22: U1.Q7 (A22); also elsewhere on the board
A23: U1.S3 (A23); also elsewhere on the board
A24: U1.Q6 (A24); also elsewhere on the board
A25: U1.R2 (A25); also elsewhere on the board
A26: U1.S2 (A26); also elsewhere on the board
A27: U1.S1 (A27); also elsewhere on the board
A28: U1.R1 (A28); also elsewhere on the board
A29: U1.P2 (A29); also elsewhere on the board
A30: U1.P3 (A30); also elsewhere on the board
A31: U1.Q1 (A31); also elsewhere on the board
ADS#: U1.S17 (ADS#); also elsewhere on the board
AHOLD: U1.A17 (AHOLD); also elsewhere on the board
BE0#: U1.K15 (BE0#), U2.1, U2.4, U3.2; also elsewhere on the board
BE1#: U1.J16 (BE1#), U2.2, U2.9, U2.12, U2.13; also elsewhere on the board
BE2#: U1.J15 (BE2#), U2.5; also elsewhere on the board
BE3#: U1.F17 (BE3#), U2.10; also elsewhere on the board
BHE#: U3.11; also elsewhere on the board
BLAST#: U1.R16 (BLAST#); also elsewhere on the board
BLE#: U3.8; also elsewhere on the board
BOFF#: U1.D17 (BOFF#); also elsewhere on the board
BRDY#: U1.H15 (BRDY#); also elsewhere on the board
BREQ: U1.Q15 (BREQ); also elsewhere on the board
BS8#: U1.D16 (BS8#); also elsewhere on the board
BS16#: U1.C17 (BS16#); also elsewhere on the board
CLK: U1.C3 (CLK); also elsewhere on the board
D0: U1.P1 (D0); also elsewhere on the board
D1: U1.N2 (D1); also elsewhere on the board
D2: U1.N1 (D2); also elsewhere on the board
D3: U1.H2 (D3); also elsewhere on the board
D4: U1.M3 (D4); also elsewhere on the board
D5: U1.J2 (D5); also elsewhere on the board
D6: U1.L2 (D6); also elsewhere on the board
D7: U1.L3 (D7); also elsewhere on the board
D8: U1.F2 (D8); also elsewhere on the board
D9: U1.D1 (D9); also elsewhere on the board
D10: U1.E3 (D10); also elsewhere on the board
D11: U1.C1 (D11); also elsewhere on the board
D12: U1.G3 (D12); also elsewhere on the board
D13: U1.D2 (D13); also elsewhere on the board
D14: U1.K3 (D14); also elsewhere on the board
D15: U1.F3 (D15); also elsewhere on the board
D16: U1.J3 (D16); also elsewhere on the board
D17: U1.D3 (D17); also elsewhere on the board
D18: U1.C2 (D18); also elsewhere on the board
D19: U1.B1 (D19); also elsewhere on the board
D20: U1.A1 (D20); also elsewhere on the board
D21: U1.B2 (D21); also elsewhere on the board
D22: U1.A2 (D22); also elsewhere on the board
D23: U1.A4 (D23); also elsewhere on the board
D24: U1.A6 (D24); also elsewhere on the board
D25: U1.B6 (D25); also elsewhere on the board
D26: U1.C7 (D26); also elsewhere on the board
D27: U1.C6 (D27); also elsewhere on the board
D28: U1.C8 (D28); also elsewhere on the board
D29: U1.A8 (D29); also elsewhere on the board
D30: U1.C9 (D30); also elsewhere on the board
D31: U1.B8 (D31); also elsewhere on the board
DP0: U1.N3 (DP0); also elsewhere on the board
DP1: U1.F1 (DP1); also elsewhere on the board
DP2: U1.H3 (DP2); also elsewhere on the board
DP3: U1.A5 (DP3); also elsewhere on the board
D_C#: U1.M15 (D/C#); also elsewhere on the board
EADS#: U1.B17 (EADS#); also elsewhere on the board
FERR#: U1.C14 (FERR#); also elsewhere on the board
FLUSH#: U1.C15 (FLUSH#); also elsewhere on the board
GND: C1.1, C2.1, C3.1, C4.1, C5.1, C6.1, C7.1, C8.1, C9.2, C10.2, U1.A7 (Vss), U1.A9 (Vss), U1.A11 (Vss), U1.B3 (Vss), U1.B4 (Vss), U1.B5 (Vss), U1.E1 (Vss), U1.E17 (Vss), U1.G1 (Vss), U1.G17 (Vss), U1.H1 (Vss), U1.H17 (Vss), U1.K1 (Vss), U1.K17 (Vss), U1.L1 (Vss), U1.L17 (Vss), U1.M1 (Vss), U1.M17 (Vss), U1.P17 (Vss), U1.Q2 (Vss), U1.R4 (Vss), U1.S6 (Vss), U1.S8 (Vss), U1.S9 (Vss), U1.S10 (Vss), U1.S11 (Vss), U1.S12 (Vss), U1.S14 (Vss), U2.7 (GND), U3.7 (GND); also elsewhere on the board
HLDA: U1.P15 (HLDA); also elsewhere on the board
HOLD: U1.E15 (HOLD); also elsewhere on the board
IGNNE#: U1.A15 (IGNNE#); also elsewhere on the board
INTR: U1.A16 (INTR); also elsewhere on the board
KEN#: U1.F15 (KEN#); also elsewhere on the board
LOCK#: U1.N15 (LOCK#); also elsewhere on the board
M_IO#: U1.N16 (M/IO#); also elsewhere on the board
NC_A3: U1.A3 (TCK); also elsewhere on the board
NC_A10: U1.A10 (INV); also elsewhere on the board
NC_A12: U1.A12 (HITM#); also elsewhere on the board
NC_A13: U1.A13 (NC); also elsewhere on the board
NC_A14: U1.A14 (TDI); also elsewhere on the board
NC_B10: U1.B10 (SMI#); also elsewhere on the board
NC_B12: U1.B12 (CACHE#); also elsewhere on the board
NC_B13: U1.B13 (WB/WT#); also elsewhere on the board
NC_B14: U1.B14 (TMS); also elsewhere on the board
NC_B16: U1.B16 (TDO); also elsewhere on the board
NC_C10: U1.C10 (SRESET); also elsewhere on the board
NC_C11: U1.C11 (UP#); also elsewhere on the board
NC_C12: U1.C12 (SMIACT#); also elsewhere on the board
NC_C13: U1.C13 (NC); also elsewhere on the board
NC_G15: U1.G15 (STPCLK#); also elsewhere on the board
NC_R17: U1.R17 (CLKMUL); also elsewhere on the board
NC_S4: U1.S4 (VOLDET); also elsewhere on the board
NMI: U1.B15 (NMI); also elsewhere on the board
unnamed: U2.3, U3.4, U3.5
unnamed: U2.6, U3.9
unnamed: U2.8, U3.12, U3.13
unnamed: U2.11, U3.1
unnamed: U3.3, U3.10
PCD: U1.J17 (PCD); also elsewhere on the board
PCHK#: U1.Q17 (PCHK#); also elsewhere on the board
PLOCK#: U1.Q16 (PLOCK#); also elsewhere on the board
PWT: U1.L15 (PWT); also elsewhere on the board
RDY#: U1.F16 (RDY#); also elsewhere on the board
RESET: U1.C16 (RESET); also elsewhere on the board
VCC: C1.2, C2.2, C3.2, C4.2, C5.2, C6.2, C7.2, C8.2, C9.1, C10.1, U1.B7 (Vcc), U1.B9 (Vcc), U1.B11 (Vcc), U1.C4 (Vcc), U1.C5 (Vcc), U1.E2 (Vcc), U1.E16 (Vcc), U1.G2 (Vcc), U1.G16 (Vcc), U1.H16 (Vcc), U1.K2 (Vcc), U1.K16 (Vcc), U1.L16 (Vcc), U1.M2 (Vcc), U1.M16 (Vcc), U1.P16 (Vcc), U1.R3 (Vcc), U1.R6 (Vcc), U1.R8 (Vcc), U1.R9 (Vcc), U1.R10 (Vcc), U1.R11 (Vcc), U1.R14 (Vcc), U2.14 (VCC), U3.14 (VCC); also elsewhere on the board
W_R#: U1.N17 (W/R#); also elsewhere on the board

Notes on the sheet:
A1, BHE#, BLE# Logic Provided by the 486 Data Sheet
BLE# is also A0

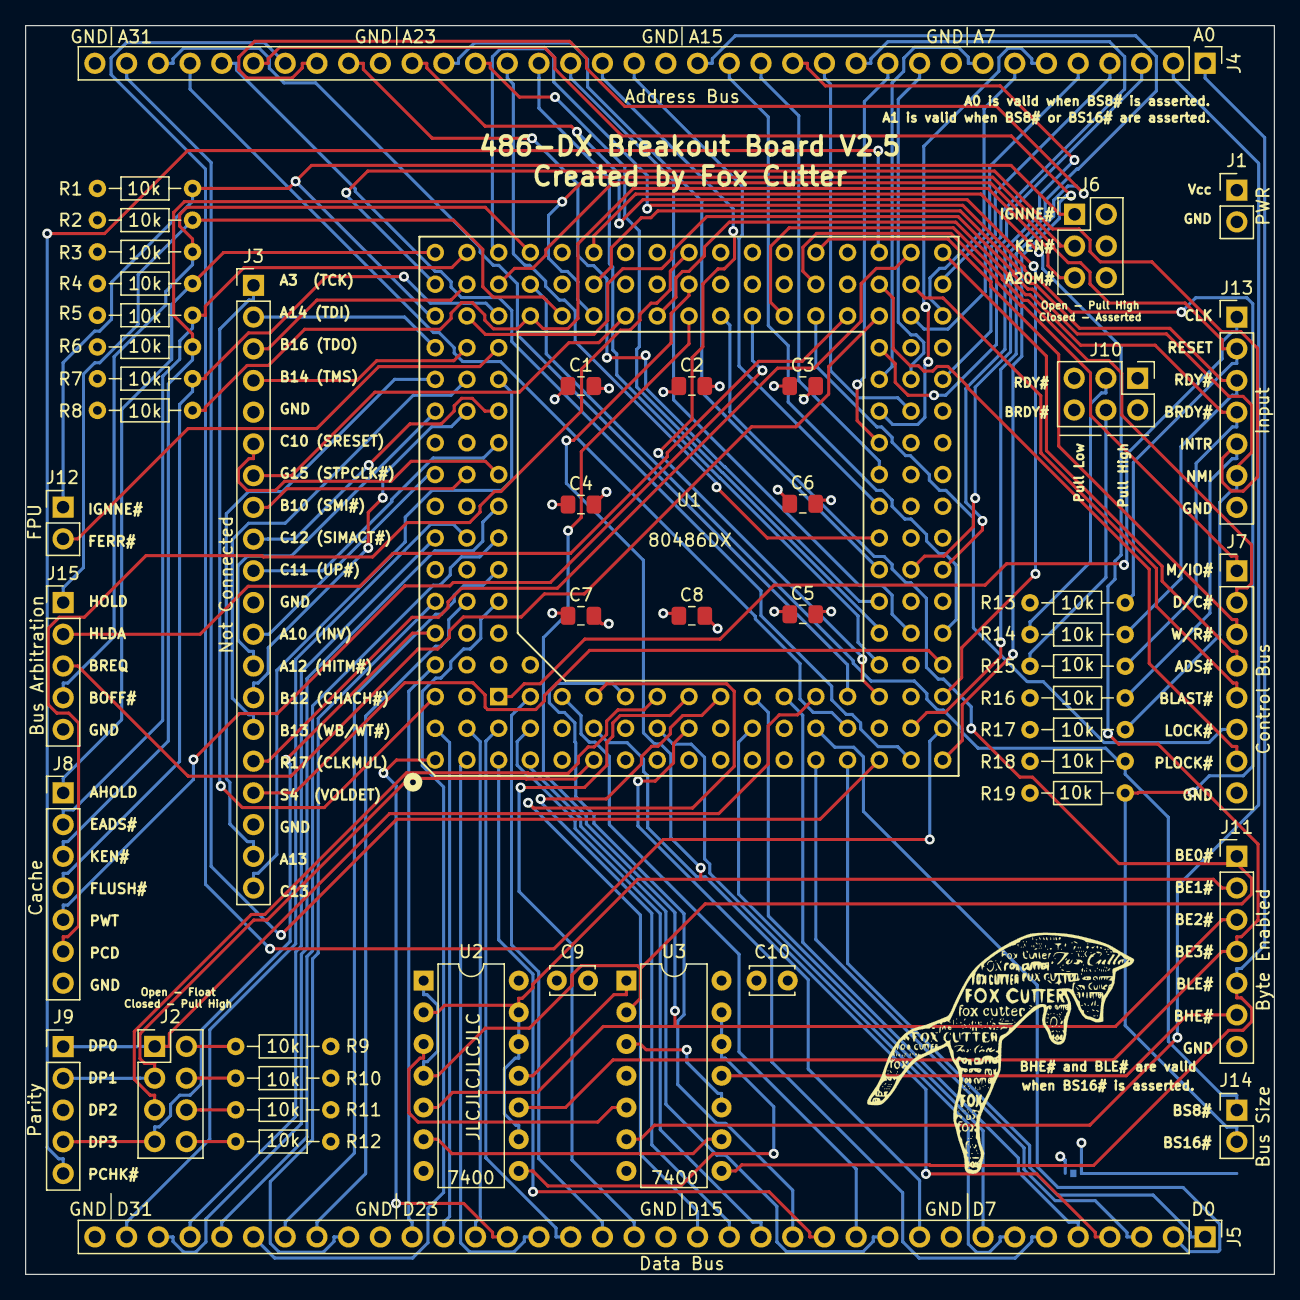
[picture p9: board 486 Breakout.kicad_pcb from above]

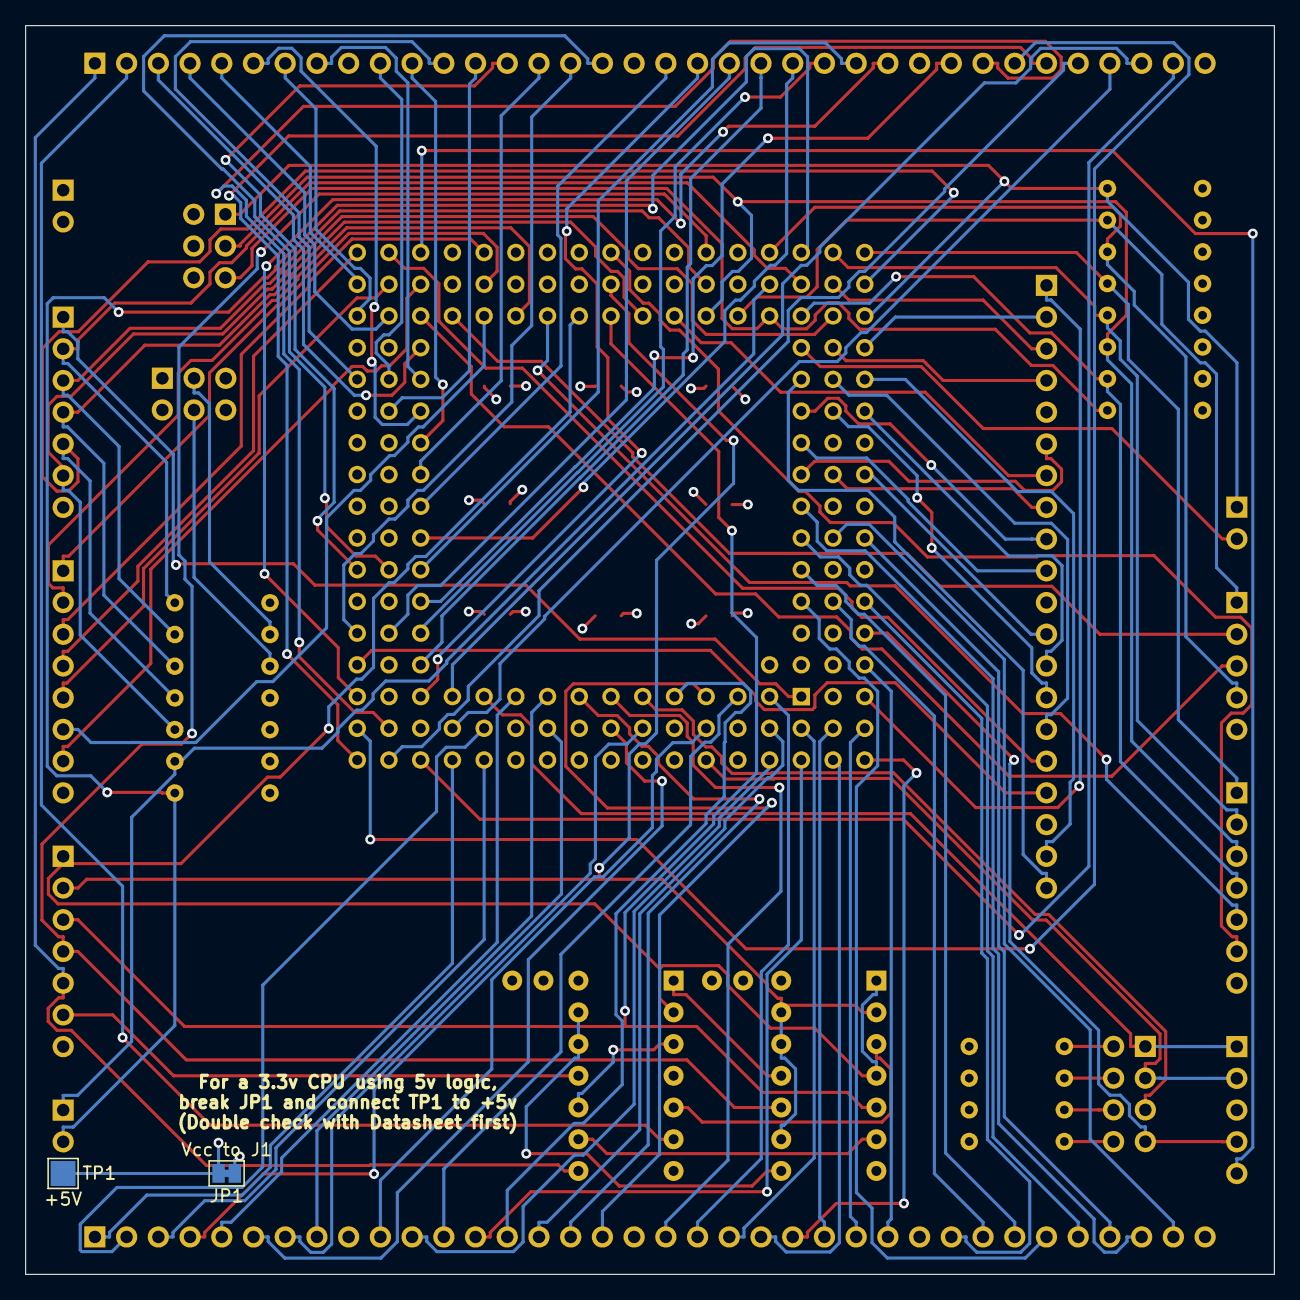
[picture p10: board 486 Breakout.kicad_pcb from below]

Board: 4 copper layers, 100.0 x 100.0 mm, 49 parts (2 on the bottom side), 133 nets.
