FoxCutter/486Dev/(commit log)

2023-01-10 Added a 486 beakout pcb
    [486 Breakout.kicad_pcb, 486 Breakout.sch, CPUSheet.sch]
2023-02-01 V2 of the board
    [486 Breakout.kicad_pcb, 486 Breakout.sch, CPUSheet.sch]
2023-02-05 * Update to Kicad 6
    [486 Breakout.kicad_pcb, 486 Breakout.kicad_sch, 486 Breakout.sch, CPUSheet.kicad_sch, CPUSheet.sch]
2023-03-17 Adding License and Readme for the 486 Breakout board
2023-03-17 Updating the 486 Breakout Board
    [486 Breakout.kicad_pcb, 486 Breakout.kicad_sch, CPUSheet.kicad_sch]
2023-03-22 Moving FIles
    [486 Breakout.kicad_pcb, 486 Breakout.kicad_sch, CPUSheet.kicad_sch]
2023-04-05 * Updating the 486 PCB * TestRom2 added
    [486 Breakout.kicad_pcb, 486 Breakout.kicad_sch]
2023-05-07 UART testing
2023-05-18 Adding first draft of 486 support board
    [486 Board.kicad_sch, 486Bus.kicad_sch, AddresBusControl.kicad_sch, CPU.kicad_sch, ControlLineProcessing.kicad_sch, DataBus.kicad_sch]
2023-05-29 Minor PCB updates, and adding Gerber files
    [486 Breakout.kicad_pcb]
2023-06-12 * Layout Template for eurocard format * 486 Board updated to new layout * Support board draft * Added 6u eurocard backplane meant for ATX case
    [486 Board.kicad_sch, 486Bus.kicad_sch, AddresBusControl.kicad_sch, Backplane.kicad_sch, Breakout.kicad_sch, Bus.kicad_sch, Bus1.kicad_sch, Bus2.kicad_sch]
